npiscitello/BoilerControl/Documentation/Design_Documentation_20150605.pdf

# Boiler Control Project

# Nick Piscitello, Joe Piscitello: 2014 - 15

## Design Specifications

### What is the device’s desired operation?

- If the stove is above a user-defined threshold, turn the circulators on for a user-defined amount of time, then rest for a user-defined amount of time. Also, if the stove is hot, operate on the I/O device (encoder with button, 3 digit LCD, 4 indicator LEDs).

### What are the device’s main tasks?

- I/O: more of a function library than a true task - presents inputs when requested by meta-management (encoder value, thermistor value, etc), then outputs data to the display when told to by meta-management
- meta-management: adjust and monitor applicable variables (stove temperature, temperature threshold, circulate time, delay time), keep track of periodic tasks (temperature
measurement, I/O output)
- circulator control: cycle the relay controlling the circulator loops

### Software design:

- 3 modules, each pertaining to a main task (I/O, meta-management, circulator control)
- each module is completely separate from the others, plug-n’-play
■ write each as a library? Read up on C++ classing...
- there should be no code for any module in the loop() function

## Pseudocode - all code assumes stove temp is over threshold

Module1:I/O
control
- listenforastart/stopcommandfrommeta-management
- low-powerlistenermodeifstopped

input
- dealswithdirtyworkofreadingtheencoderandthethermistor
- processesandpresentsanarray(ormatrix)ofvaluestometa-management

output
- willreceiveanarray(ormatrix)ofthe4variablesandtheindexvariable
- readsmatrix,displaystheappropriateinformation
- WILLNOThandleupdatingthevariablesorindex;that’sformeta-management

Module2:meta-management
acquisition
- askI/Omoduleforrelativeencoderreadingandthermistorreading

processing
- testforthresholds
- updatevariables

export
- packageandsenddisplaydatatoI/Omodule
- packageandsendtimingdatatocirculatorcontrolmodule

Module3:circulatorcontrol
reciept
- willlistenforanarrayoftimingdata(int[circ,rest]forexample)anda start/stopbooleanvaluefrommeta-management

control
- operatewithanyreceivedtimingdataifthestartbitisset;runavery low-powerlistenermodeifstopped

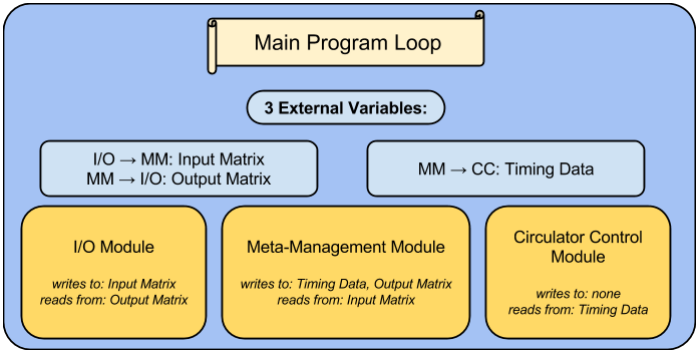
[picture p1: figure]
