npiscitello/BoilerControl/Documentation/Schematic.pdf

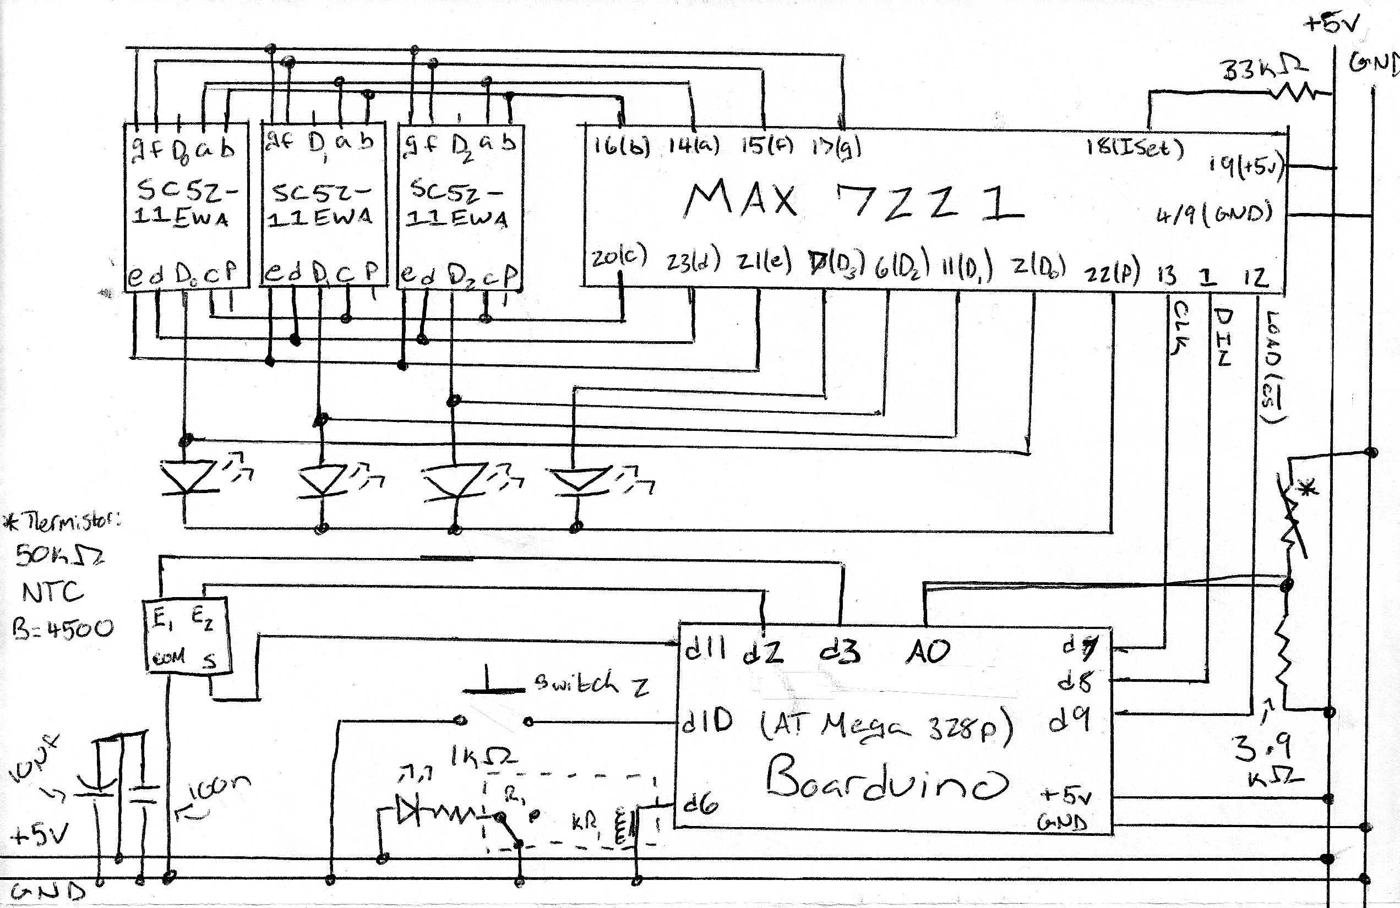
[picture p2: page 1]
