npiscitello/BoilerControl/(commit log)

2015-10-15 Integrated circulator on/off into IO - it belongs there, being an output device. MetaMgmt will control timing, still not IOs job!
2015-10-15 continued to develop framework
2015-10-16 Finished integrating MetaMgmt - should be fully operational (with a few tweaks). Encoder.h has developed an error...?
2015-10-16 updated todo, added needed utilities files for Encoder library. Tracking down errors and warnings - complaining about comparing signed ints to unsigned ints and errors related to using interrupts wit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
2015-10-20 Tried a clean slate (re-import from GitHub) - didn't help
    [BoilerControl.cpp]
2015-10-21 Updated for readablility - need to test with arduino
2015-10-21 tested with arduino and fixed issues - need to implement therm avging
    [BoilerControl.cpp]
2015-10-26 Added button press and long press feature - just placeholders
2015-10-27 Tried to tune thermistor reading, didn't work. At ~70 deg, it reads ~60 deg F... is it a true linear offset, or variable according to the temperature being read? Calibrate it accordingly...
    [BoilerControl.cpp]
2015-11-18 Made framework for EEPROM and wear-leveling; renamed to STORAGE to prevent overlap with Arduino EEPROM library
    [BoilerControl.cpp]
2017-01-24 added board info
